SanujaRupasinghe/WaveHarmony/Documentation/Pictures/final design.PNG

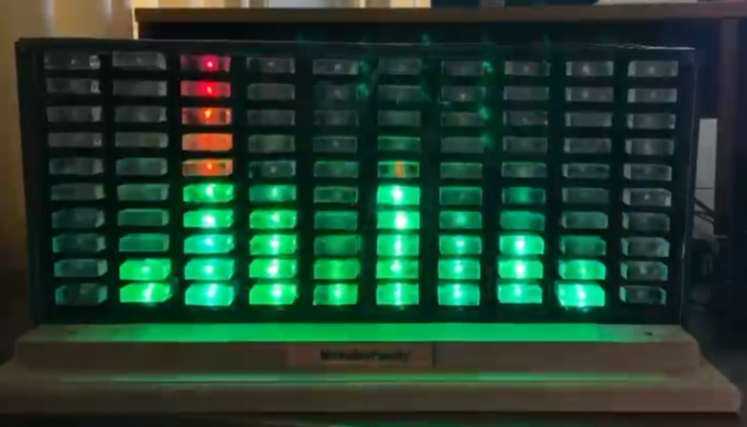
Documentation/Pictures/final design.PNG
