SanujaRupasinghe/WaveHarmony/Documentation/Pictures/PCB.jpg

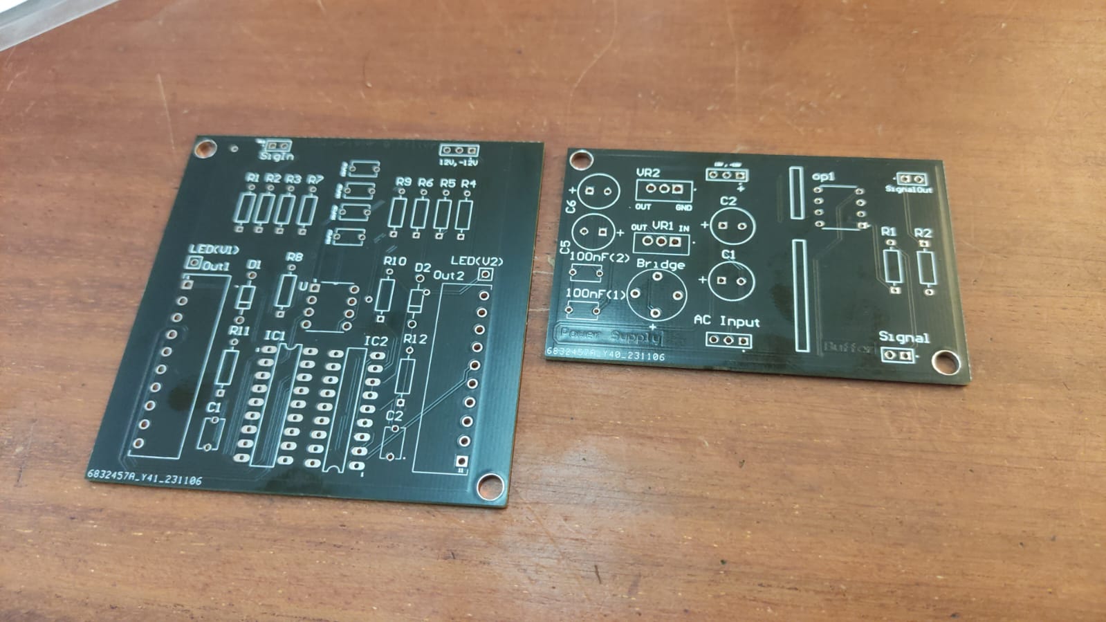
Documentation/Pictures/PCB.jpg
