SanujaRupasinghe/WaveHarmony/Documentation/Pictures/acrylic .jpg

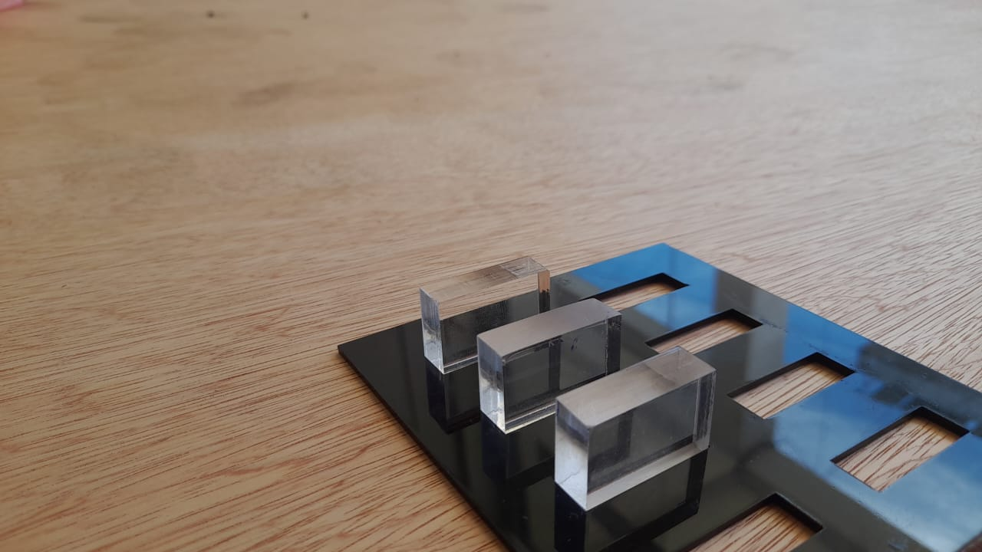
Documentation/Pictures/acrylic .jpg
