SanujaRupasinghe/WaveHarmony/Documentation/Pictures/working power supply.jpg

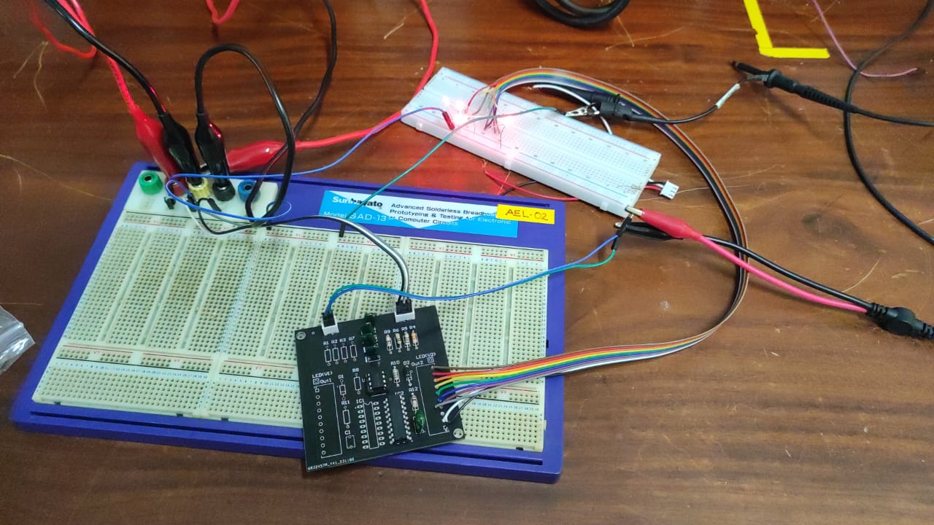
Documentation/Pictures/working power supply.jpg
