SanujaRupasinghe/WaveHarmony/Enclosure/Assembly.SLDASM

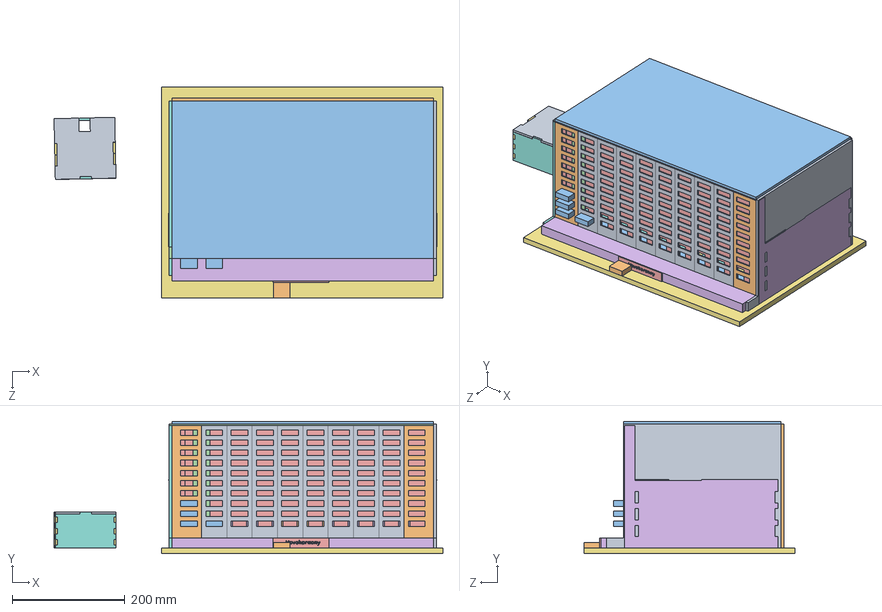
[picture p34: CAD file, 2024-08-10]
Enclosure/Assembly.SLDASM
691.3 x 235.0 x 375.0 mm
BlockHolderMid x 8
BlockHolderSide x 2
Blocks x 4
BlockHolderMidSupport
BlockHolderSideSupport
FontSupport
Base
FilterLEDDrivePCB x 5
PowerSupply x 2
Transformer
BackSupport x 2
Transformer Front x 2
Transormer Side x 2
Transormer Top
Name
N - LR
N - LR 2
N - Back
N - Top
