SanujaRupasinghe/WaveHarmony/Enclosure/Transformer/TransformerAssembly.SLDASM

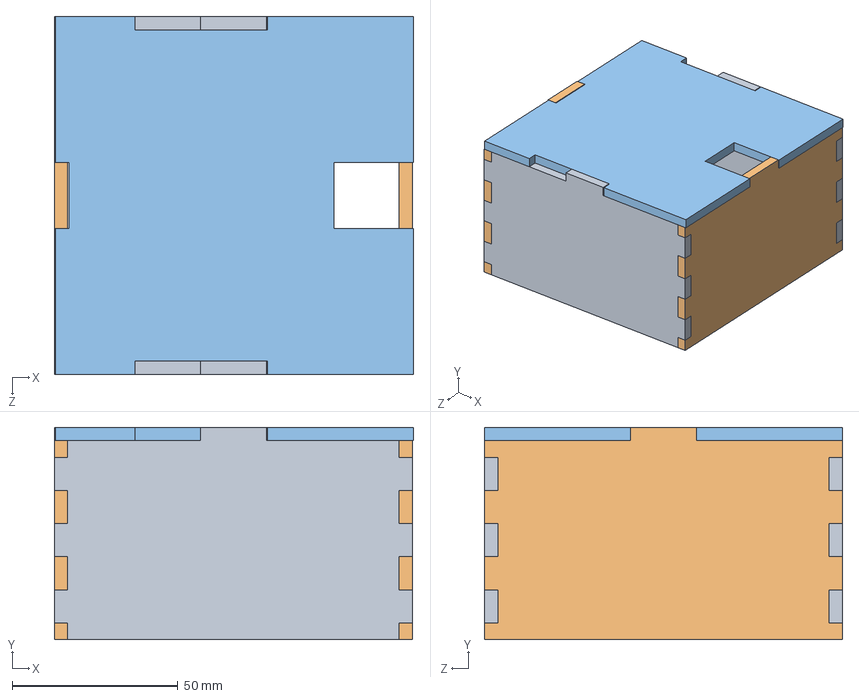
[picture p35: CAD file, 2024-08-10]
Enclosure/Transformer/TransformerAssembly.SLDASM
108.3 x 64.0 x 108.0 mm
Transformer Front x 2
Transormer Side x 2
Transormer Top
