SanujaRupasinghe/WaveHarmony/Enclosure/Support/Sup.SLDPRT

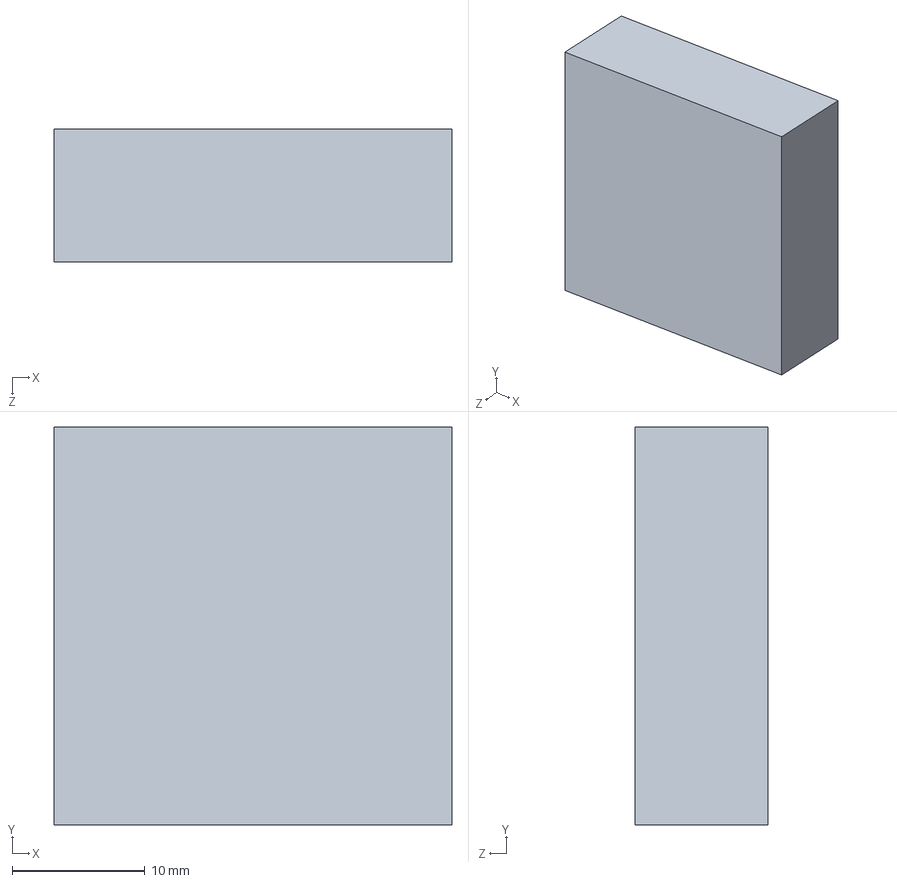
[picture p36: CAD file, 2024-08-10]
Enclosure/Support/Sup.SLDPRT
30.0 x 30.0 x 10.0 mm
