SanujaRupasinghe/WaveHarmony/Enclosure/Transformer/Transformer Front.SLDPRT

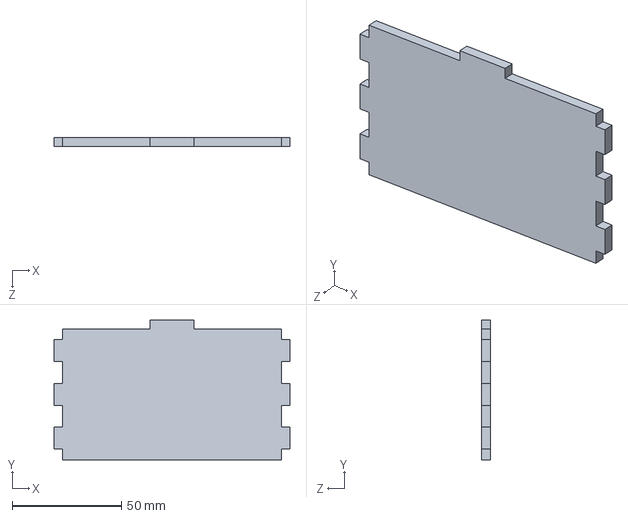
[picture p37: CAD file, 2024-08-10]
Enclosure/Transformer/Transformer Front.SLDPRT
108.0 x 64.0 x 4.00 mm
