SanujaRupasinghe/WaveHarmony/Enclosure/FilterLEDDrivePCB.SLDPRT

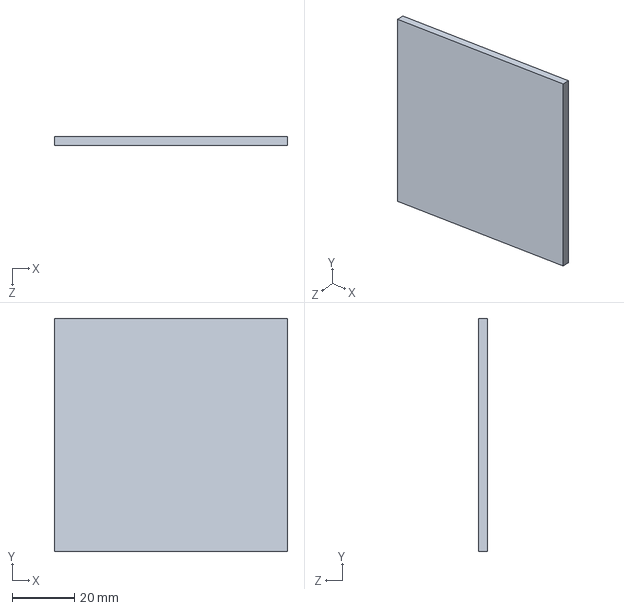
[picture p38: CAD file, 2024-08-10]
Enclosure/FilterLEDDrivePCB.SLDPRT
75.0 x 75.0 x 3.00 mm
