SanujaRupasinghe/WaveHarmony/Enclosure/HideBulbsHighTop.SLDPRT

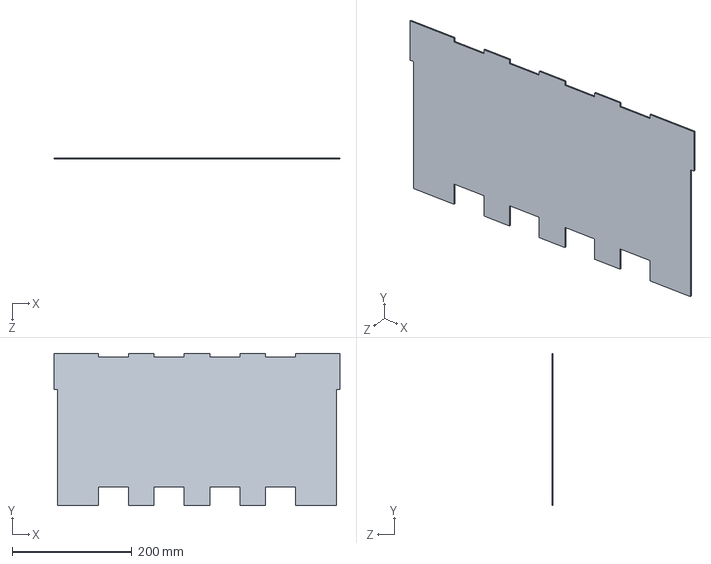
[picture p39: CAD file, 2024-08-10]
Enclosure/HideBulbsHighTop.SLDPRT
477.0 x 254.0 x 2.00 mm
