SanujaRupasinghe/WaveHarmony/Enclosure/BackSupport.SLDPRT

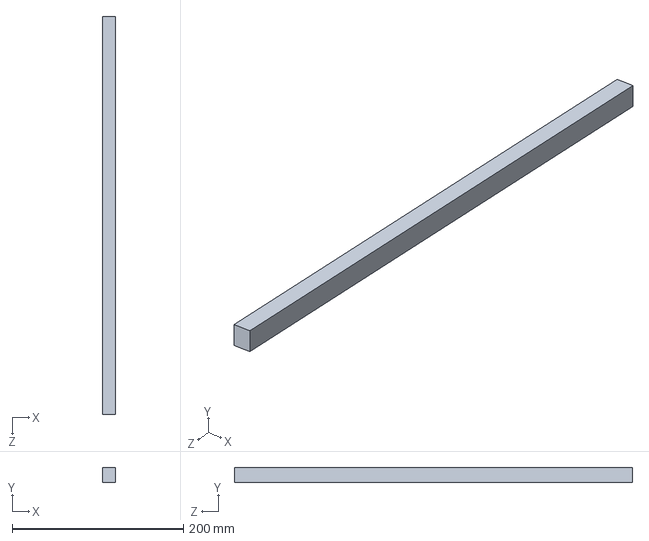
[picture p40: CAD file, 2024-08-10]
Enclosure/BackSupport.SLDPRT
15.0 x 18.0 x 465.0 mm
