SanujaRupasinghe/WaveHarmony/Enclosure/Transformer/Transormer Top.SLDPRT

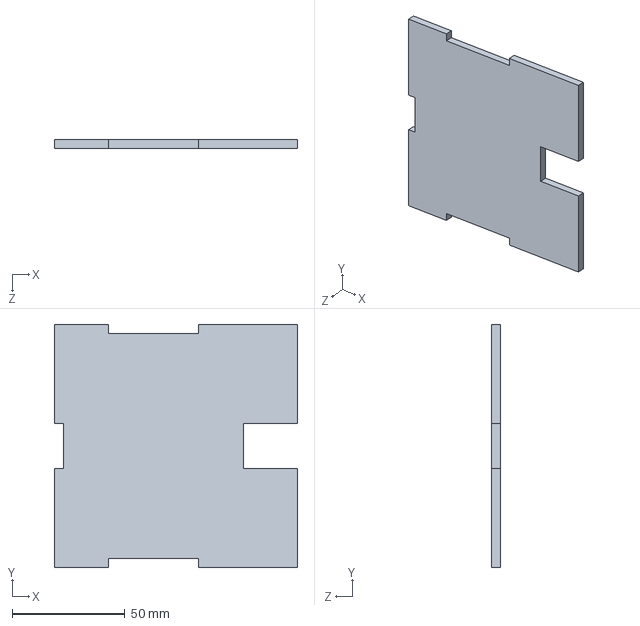
[picture p41: CAD file, 2024-08-10]
Enclosure/Transformer/Transormer Top.SLDPRT
108.0 x 108.0 x 4.00 mm
