SanujaRupasinghe/WaveHarmony/Enclosure/Transformer Front.SLDPRT

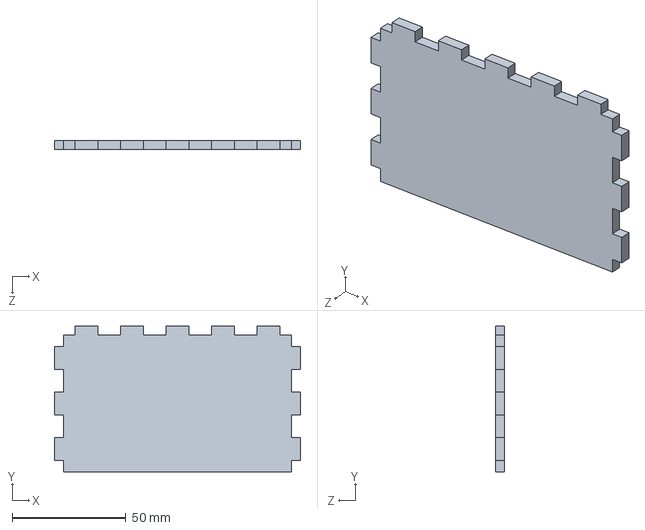
[picture p42: CAD file, 2024-08-10]
Enclosure/Transformer Front.SLDPRT
108.0 x 64.0 x 4.00 mm
