SanujaRupasinghe/WaveHarmony/Enclosure/N - Top.SLDPRT

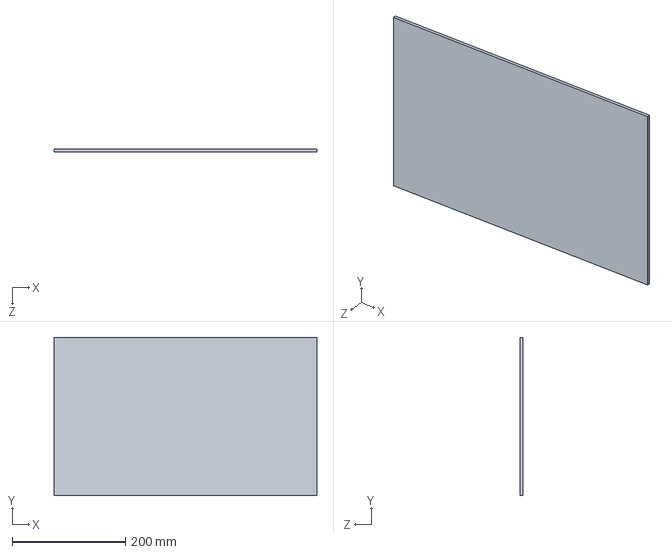
[picture p43: CAD file, 2024-08-10]
Enclosure/N - Top.SLDPRT
465.0 x 280.0 x 5.00 mm
