SanujaRupasinghe/WaveHarmony/Enclosure/BlockHolderSideSupport.SLDPRT

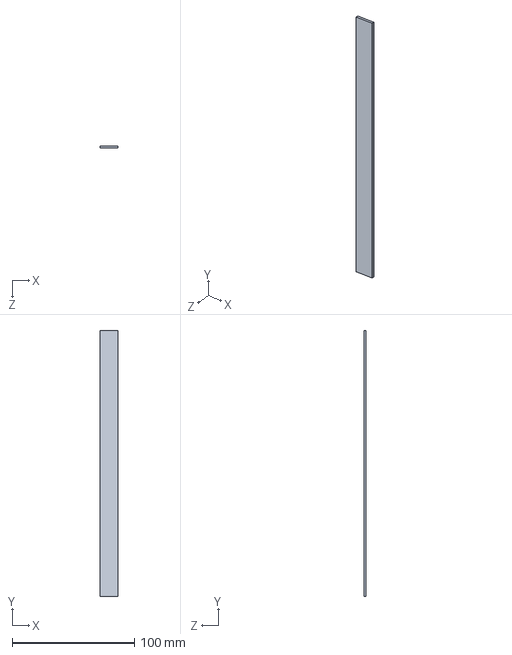
[picture p44: CAD file, 2024-08-10]
Enclosure/BlockHolderSideSupport.SLDPRT
15.0 x 218.0 x 2.00 mm
