SanujaRupasinghe/WaveHarmony/Enclosure/Transformer Top Good.SLDPRT

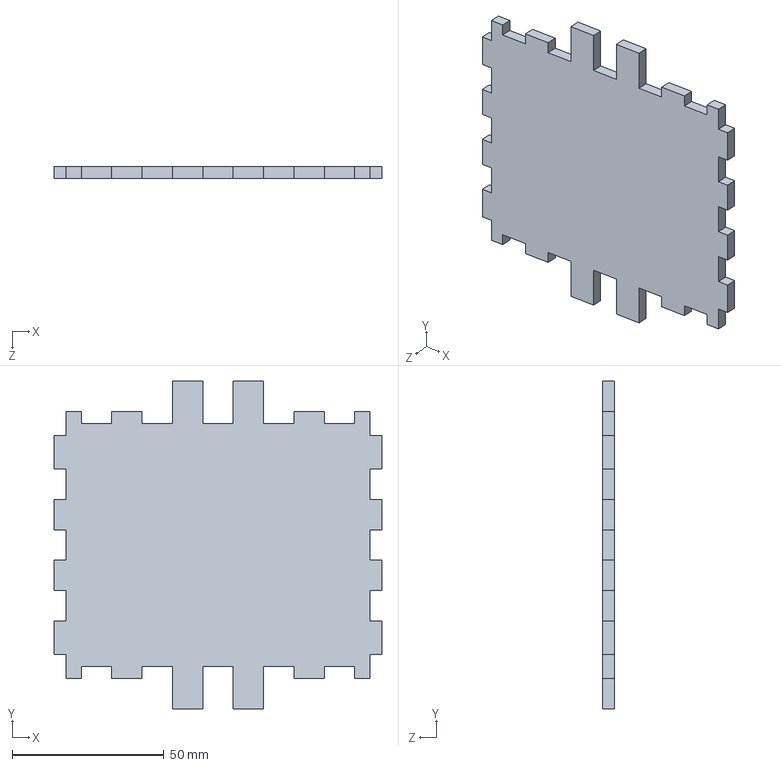
[picture p45: CAD file, 2024-08-10]
Enclosure/Transformer Top Good.SLDPRT
108.0 x 108.0 x 4.00 mm
