SanujaRupasinghe/WaveHarmony/Enclosure/Transformer Side V2.SLDPRT

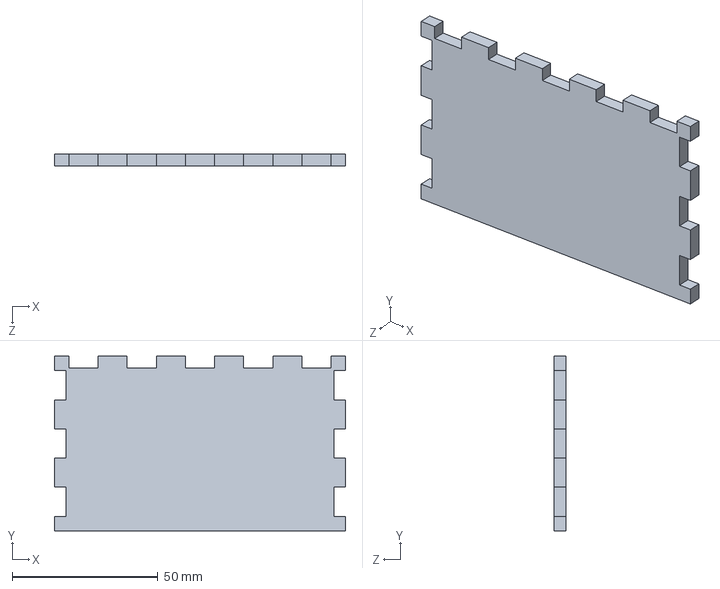
[picture p46: CAD file, 2024-08-10]
Enclosure/Transformer Side V2.SLDPRT
100.0 x 60.0 x 4.00 mm
