SanujaRupasinghe/WaveHarmony/Enclosure/HideWires.SLDPRT

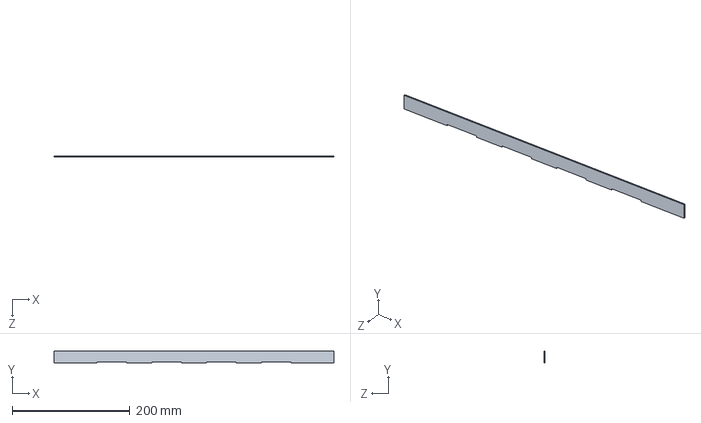
[picture p47: CAD file, 2024-08-10]
Enclosure/HideWires.SLDPRT
475.0 x 21.0 x 2.00 mm
