SanujaRupasinghe/WaveHarmony/Enclosure/Transformer.SLDPRT

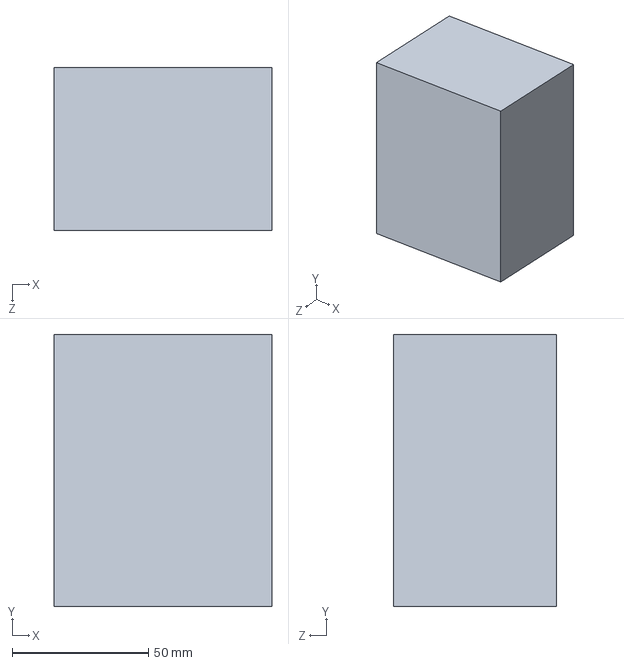
[picture p48: CAD file, 2024-08-10]
Enclosure/Transformer.SLDPRT
80.0 x 100.0 x 60.0 mm
