SanujaRupasinghe/WaveHarmony/Enclosure/Blocks.SLDPRT

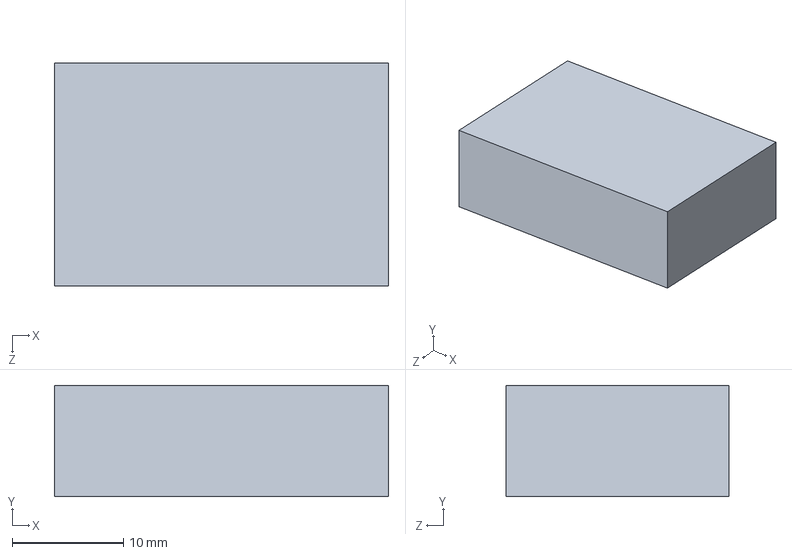
[picture p49: CAD file, 2024-08-10]
Enclosure/Blocks.SLDPRT
30.0 x 10.0 x 20.0 mm
