SanujaRupasinghe/WaveHarmony/Enclosure/N - LR 2.SLDPRT

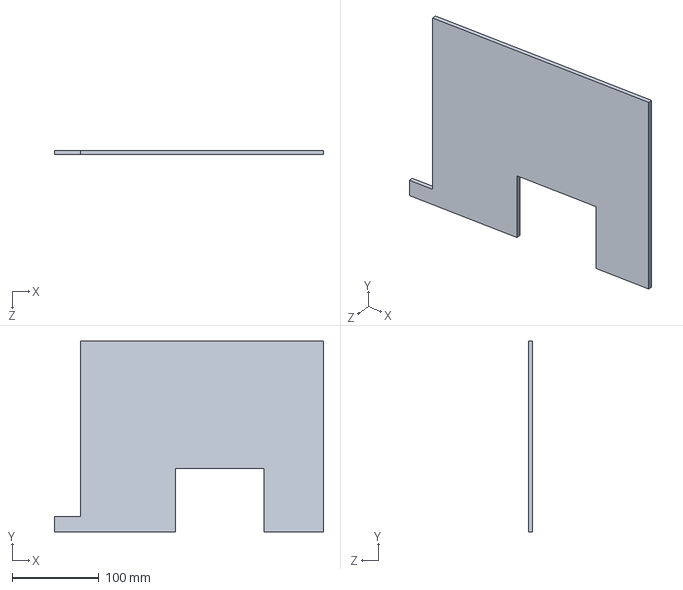
[picture p50: CAD file, 2024-08-10]
Enclosure/N - LR 2.SLDPRT
310.0 x 220.0 x 5.00 mm
