SanujaRupasinghe/WaveHarmony/Enclosure/HideBulbs.SLDPRT

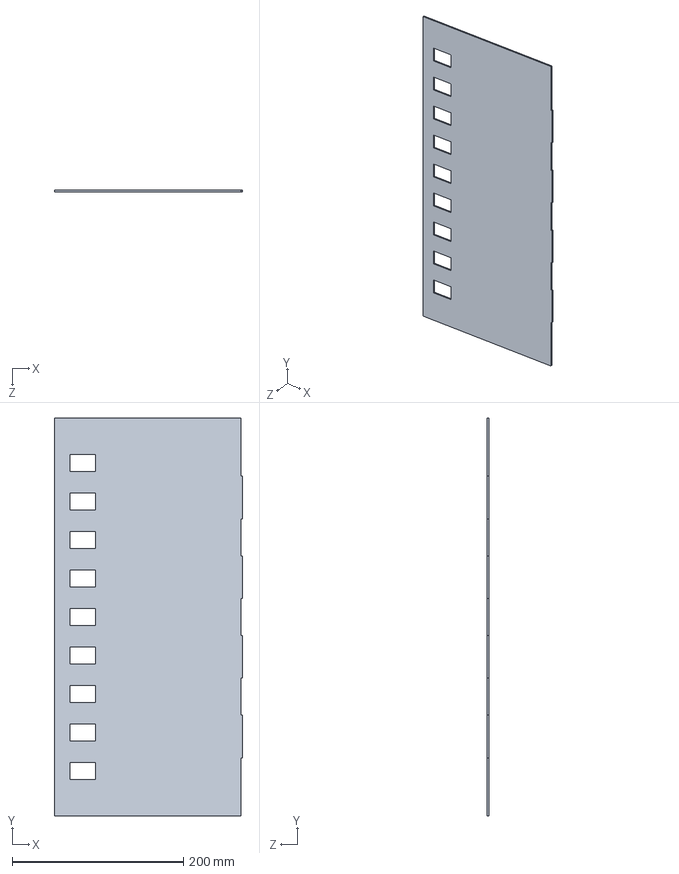
[picture p51: CAD file, 2024-08-10]
Enclosure/HideBulbs.SLDPRT
220.0 x 465.0 x 2.00 mm
