SanujaRupasinghe/WaveHarmony/Enclosure/Base.SLDPRT

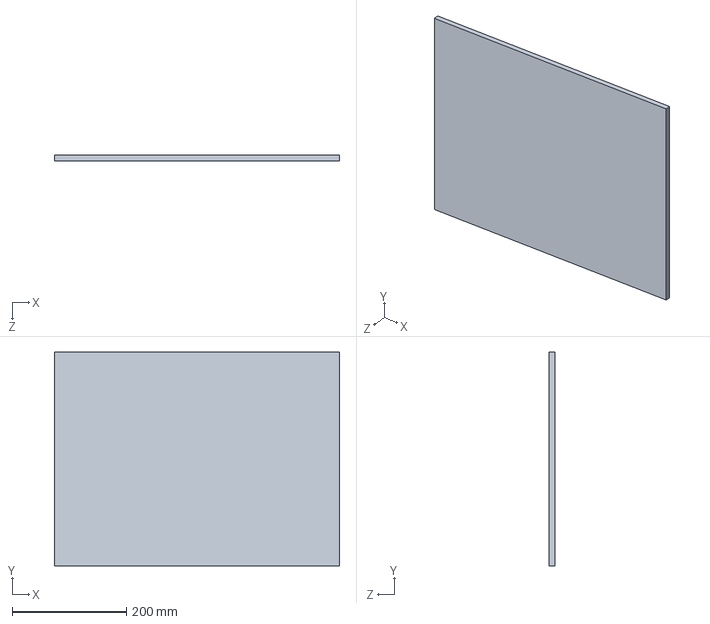
[picture p52: CAD file, 2024-08-10]
Enclosure/Base.SLDPRT
500.0 x 375.0 x 10.0 mm
