SanujaRupasinghe/WaveHarmony/Enclosure/BlockHolderMid.SLDPRT

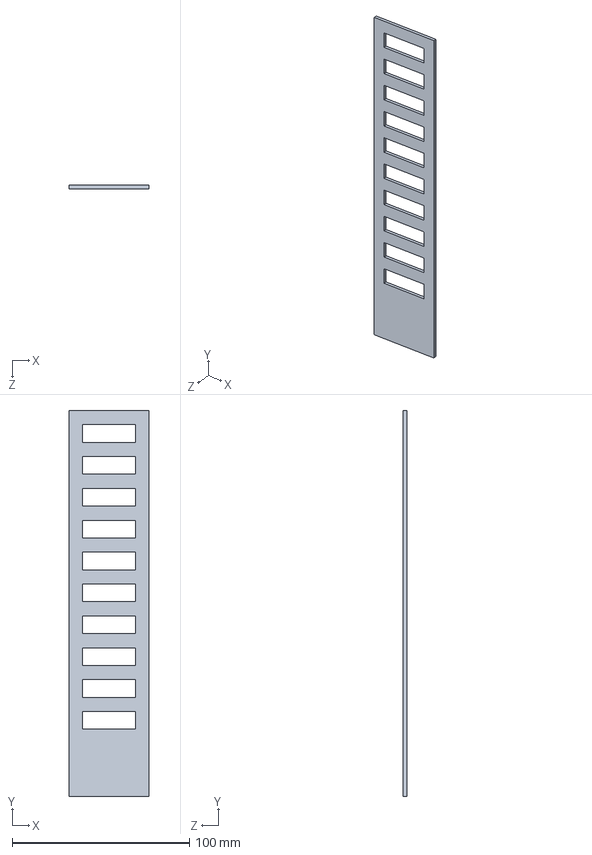
[picture p53: CAD file, 2024-08-10]
Enclosure/BlockHolderMid.SLDPRT
45.0 x 218.0 x 2.00 mm
