SanujaRupasinghe/WaveHarmony/Enclosure/PowerSupply.SLDPRT

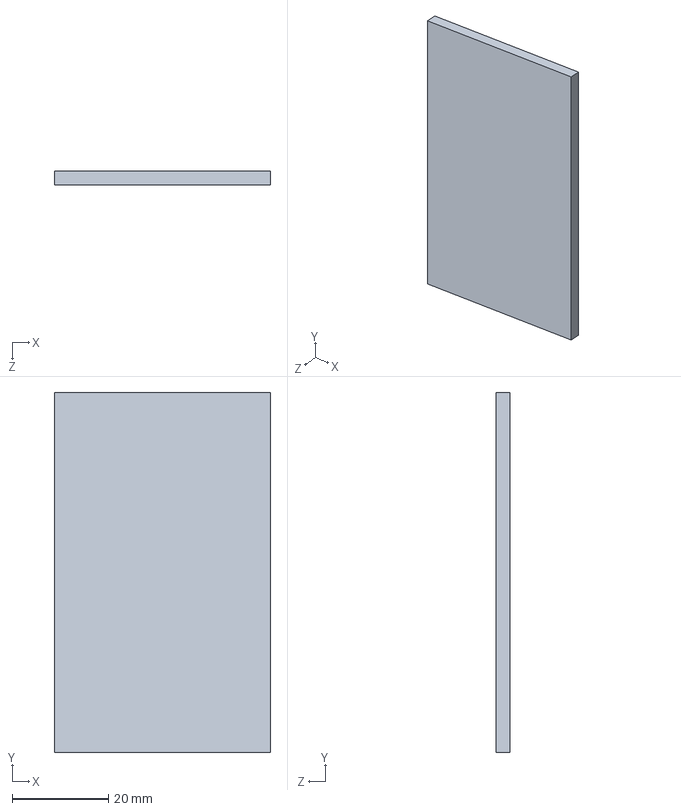
[picture p54: CAD file, 2024-08-10]
Enclosure/PowerSupply.SLDPRT
45.0 x 75.0 x 3.00 mm
