SanujaRupasinghe/WaveHarmony/Enclosure/HideBulbsHighSide.SLDPRT

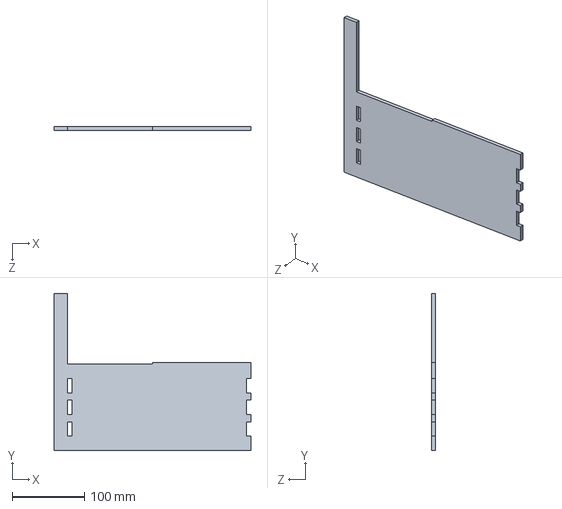
[picture p55: CAD file, 2024-08-10]
Enclosure/HideBulbsHighSide.SLDPRT
273.0 x 218.0 x 5.00 mm
