SanujaRupasinghe/WaveHarmony/Enclosure/N - Back.SLDPRT

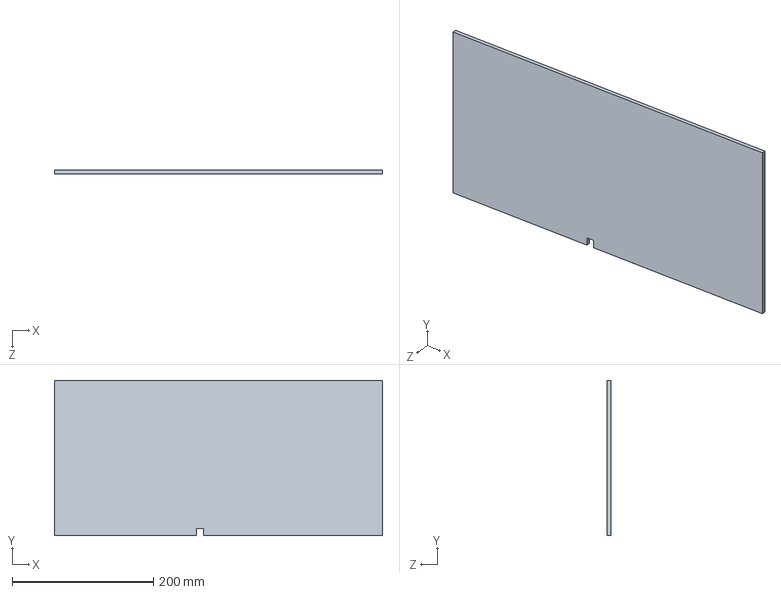
[picture p56: CAD file, 2024-08-10]
Enclosure/N - Back.SLDPRT
465.0 x 220.0 x 5.00 mm
