SanujaRupasinghe/WaveHarmony/Enclosure/HideBulbsHighBack.SLDPRT

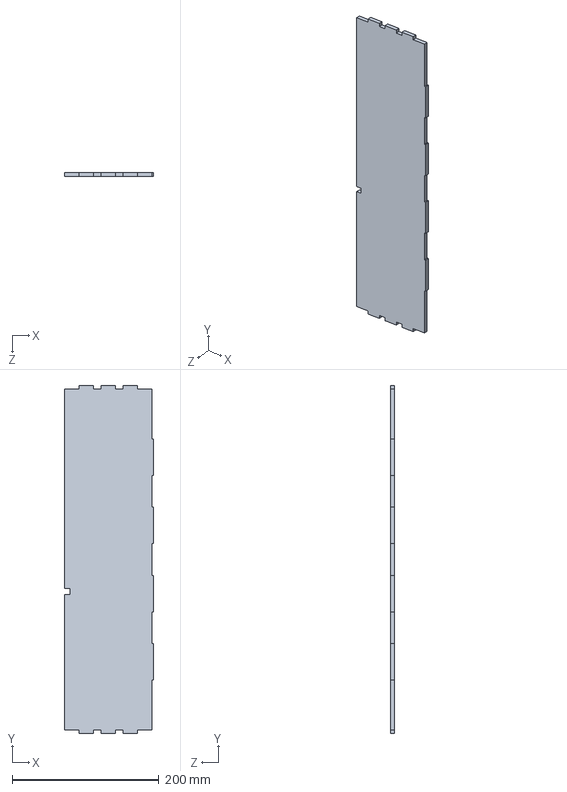
[picture p57: CAD file, 2024-08-10]
Enclosure/HideBulbsHighBack.SLDPRT
122.0 x 475.0 x 6.00 mm
