SanujaRupasinghe/WaveHarmony/Enclosure/Name.SLDPRT

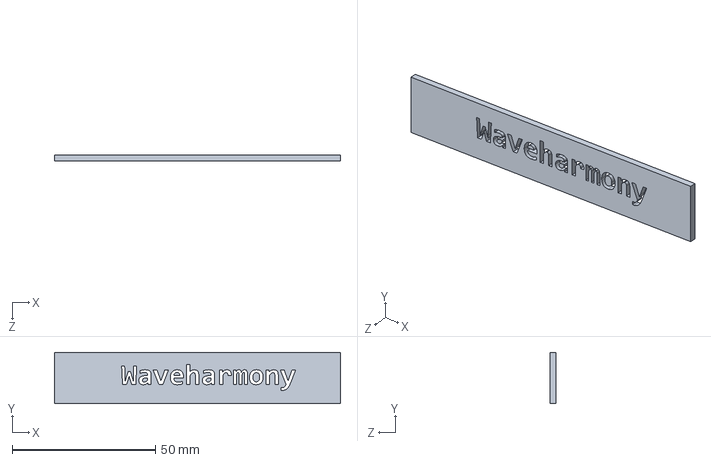
[picture p58: CAD file, 2024-08-10]
Enclosure/Name.SLDPRT
100.0 x 18.0 x 2.00 mm
