SanujaRupasinghe/WaveHarmony/Enclosure/BlockHolderMidSupport.SLDPRT

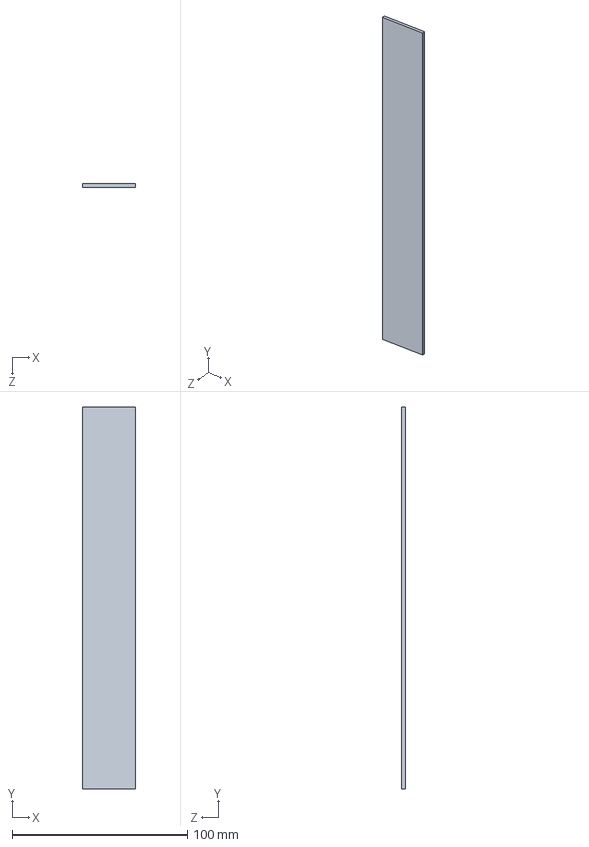
[picture p59: CAD file, 2024-08-10]
Enclosure/BlockHolderMidSupport.SLDPRT
30.0 x 218.0 x 2.00 mm
