SanujaRupasinghe/WaveHarmony/Enclosure/N - LR.SLDPRT

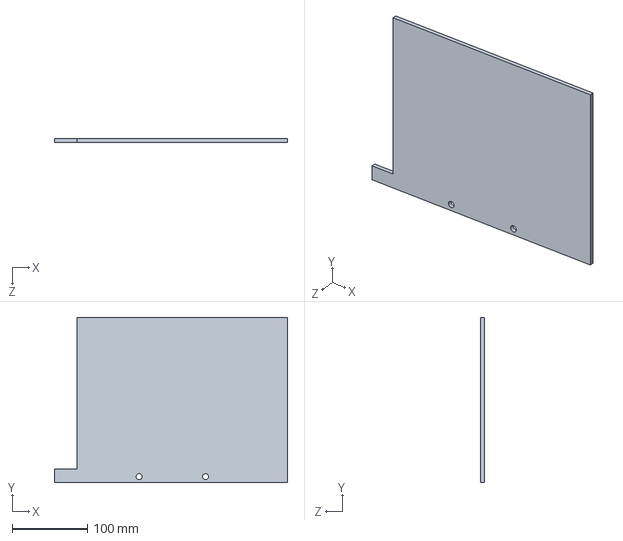
[picture p60: CAD file, 2024-08-10]
Enclosure/N - LR.SLDPRT
310.0 x 220.0 x 5.00 mm
