SanujaRupasinghe/WaveHarmony/Enclosure/HideBulbsHigh.SLDPRT

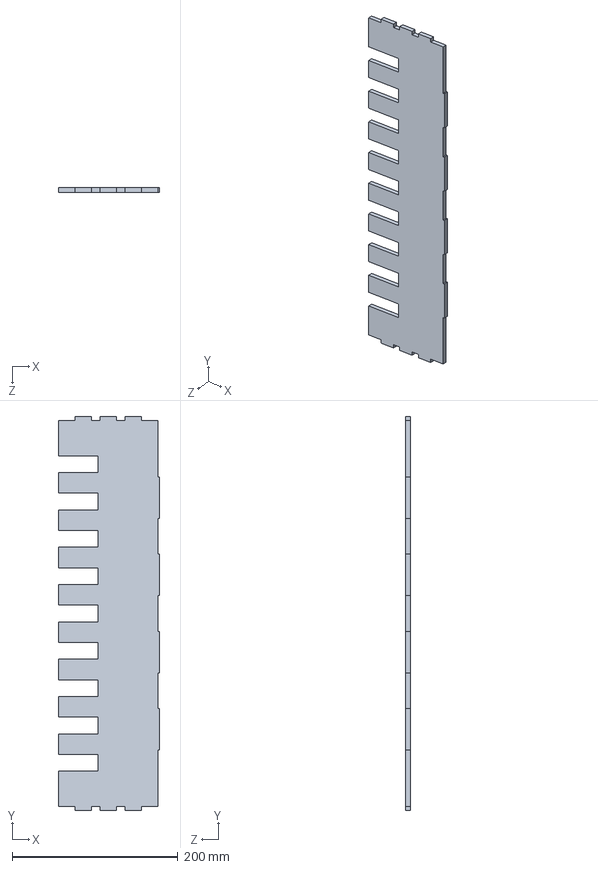
[picture p61: CAD file, 2024-08-10]
Enclosure/HideBulbsHigh.SLDPRT
122.0 x 475.0 x 6.00 mm
