SanujaRupasinghe/WaveHarmony/Enclosure/BlockHolderSide.SLDPRT

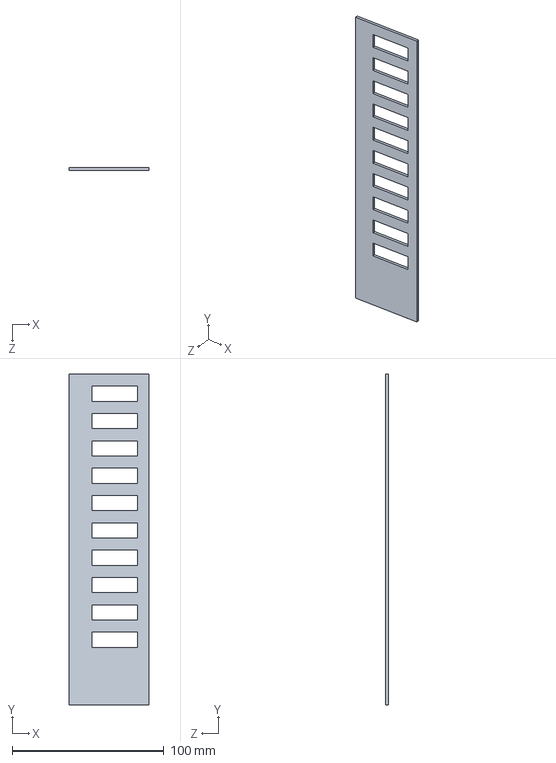
[picture p62: CAD file, 2024-08-10]
Enclosure/BlockHolderSide.SLDPRT
52.5 x 218.0 x 2.00 mm
