SanujaRupasinghe/WaveHarmony/Enclosure/Transformer Side.SLDPRT

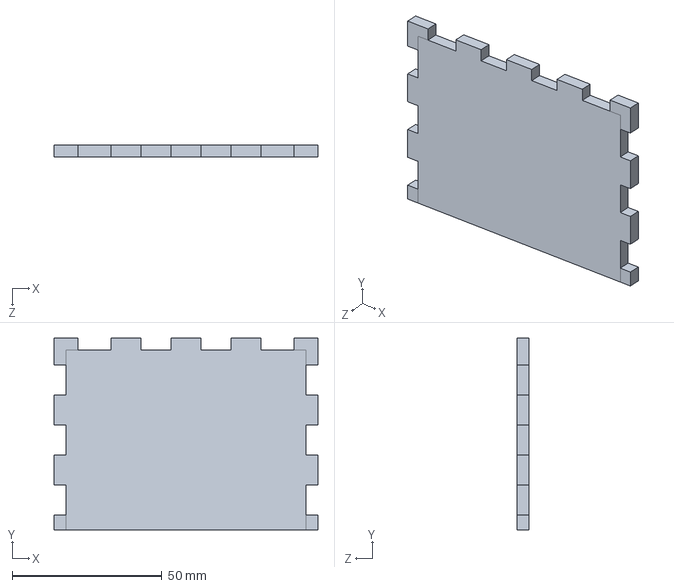
[picture p63: CAD file, 2024-08-10]
Enclosure/Transformer Side.SLDPRT
88.0 x 64.0 x 4.00 mm
