SanujaRupasinghe/WaveHarmony/(list of files, cad)

Other CAD files:
Enclosure/Transformer/Transormer Side.SLDPRT
Enclosure/FontSupport.SLDPRT
Enclosure/HideBulbsHighSide2.SLDPRT
