SanujaRupasinghe/WaveHarmony/Circuit_And_Simulation/Simulations/Filters.asc

C1: cap; 10n
C2: cap; 10n
C3: cap; 10n
C4: cap; 10n
C5: cap; 10µ
C6: cap; 10n
C7: cap; 10n
C8: cap; 10n
C9: cap; 10n
C10: cap; 10n
C11: cap; 10n
C12: cap; 10n
C13: cap; 10n
C14: cap; 10n
C15: cap; 10n
C16: cap; 10n
C17: cap; 10n
C18: cap; 10n
C19: cap; 10n
C20: cap; 10n
C21: cap; 10n
C22: cap; 10µ
C23: cap; 10µ
C24: cap; 10µ
C25: cap; 10µ
C26: cap; 10µ
C27: cap; 10µ
C28: cap; 10µ
C29: cap; 10µ
C30: cap; 10µ
D1: diode
D2: diode
D3: diode
D4: diode
D5: diode
D6: diode
D7: diode
D8: diode
D9: diode
D10: diode
R1: res; 1000k
R2: res; 68k
R3: res; 4000k
R4: res; 35k
R5: res; 500k
R6: res; 2000k
R7: res; 100k
R8: res; 16k
R9: res; 1000k
R10: res; 2k
R11: res; 128k
R12: res; 1k
R13: res; 64k
R14: res; 0.5k
R15: res; 32k
R16: res; 9k
R17: res; 500k
R18: res; 4k
R19: res; 250k
R20: res; 0.25k
R21: res; 16k
R22: res; 0.13k
R23: res; 8k
R24: res; 250k
R25: res; 128k
R26: res; 65k
R27: res; 32k
R28: res; 16k
R29: res; 8k
R30: res; 4k
R31: res; 2k
R32: res; 100k
R33: res; 100k
R34: res; 100k
R35: res; 100k
R36: res; 100k
R37: res; 100k
R38: res; 100k
R39: res; 100k
R40: res; 100k
U1: TL072
U2: TL072
U3: TL072
U4: TL072
U5: TL072
U6: TL072
U7: TL072
U8: TL072
U9: TL072
U10: TL072
V1: voltage; 15
V2: voltage; 15
V3: voltage; SINE(0 5 500); AC -1
Named nets: 0, sig
.ac dec 1000 10 5000
