SanujaRupasinghe/WaveHarmony/Circuit_And_Simulation/Simulations/Led Driver/LM3915_Test.asc

D1a: LED
D1b: LED
D2a: LED
D2b: LED
D9a: LED
D9b: LED
D10a: LED
D10b: LED
R1a: res; 1k2
R1b: res; 1k8
R2a: res; 200
R2b: res; 10k
R3a: res; 22k
U1: LM3915
U2: LM3915
V1: voltage; 2
V2: voltage; 12
V3: voltage; PULSE(1 8 0 1)
Vled: voltage; 5
Named nets: 0, In, hi1, lo1, V+, hi2, V-, lo2
.tran 0 1 1m uic
LM3915 Test Jig
Sw1
Sw2
Sw3
