SanujaRupasinghe/WaveHarmony/Circuit_And_Simulation/Simulations/Led Driver/LM3914 andLM3915/LM3914_Test.asc

D1: LED
D2: LED
D3: LED
D4: LED
D5: LED
D6: LED
D7: LED
D8: LED
R1a: res; 1k2
R1b: res; 1k8
R2a: res; 1k2
R2b: res; 8k2
R3a: res; 22k
U1: LM3914
U2: LM3914
V1: voltage; 2
V2: voltage; 12
V3: voltage; PULSE(0 10 0 1)
Vled: voltage; 5
Named nets: 0, In, hi1, lo1, V+, hi2, V-, lo2
LM3914 Test Jig
Sw1
Sw2
Sw3
Select LED type before running sim!
.dc v3 0 10 .001
