SanujaRupasinghe/WaveHarmony/Circuit_And_Simulation/Simulations/Draft1.asc

C1: cap; 1n
C2: cap; 1n
R1: res; 160k
R2: res; 636k
R3: res; 53k
U1: OP27
V1: voltage; 15
V2: voltage; 15
V3: voltage; ""; AC 1
Named nets: 0, Vout, Vin
.ac dec 100 10 2.2k
