SanujaRupasinghe/WaveHarmony/Circuit_And_Simulation/Simulations/Filter Simulations/ActiveBandpassFilter.asc

C1: cap; 0.01µ
C2: cap; 4.7n
R1: res; 470
R2: res; 1000000
R3: res; 22k
U1: opamp2; LM741
V1: voltage; ""; AC AC1 0
V2: voltage; 15
V3: voltage; 15
Named nets: 0
.include lm741.lib
.ac dec 20 1 1000k
