SanujaRupasinghe/WaveHarmony/Circuit_And_Simulation/Simulations/Filter Simulations/PassiveBandpassFilter.asc

C1: cap; 35n
C2: cap; 29n
R1: res; 10k
R2: res; 10k
V1: voltage; SINE(0 1 500); AC 1 0
Named nets: 0, out, in
HPF 450hz
LPF 550hz
.ac dec 100 1 200000000
