SanujaRupasinghe/WaveHarmony/Circuit_And_Simulation/Simulations/LM741/lm741.asc

U1: opamp2; LM741
V+: voltage; 15
v-: voltage; 15
Named nets: 0
.include lm741.lib
