SanujaRupasinghe/WaveHarmony/Circuit_And_Simulation/Simulations/TL072/Filters.asc

C1: cap; 10n
C2: cap; 10n
C3: cap; 10n
C4: cap; 10n
R1: res; 63.66k
R2: res; 4k
R3: res; 254k
R4: res; 2.12k
R5: res; 31.83k
R6: res; 127.32k
U1: TL072
U2: TL072
V1: voltage; 15
V2: voltage; 15
V3: voltage; ""; AC -1
Named nets: 0
.ac lin 100 10 2k
