SanujaRupasinghe/WaveHarmony/Circuit_And_Simulation/Simulations/Led Driver/LM3915asc/LM3915asc.asc

B1: bi; I=1u-10*i(rs)*(v(sig)>v(rlo))*((v(sig)<(v(d1)+1m))|(v(m)+0.1>=v(v+)))
B1a: bi; I=150u*(v(m)<(v(v+)-0.1))*(v(sig)>v(rlo))
B2: bi; I=1u-10*i(rs)*(v(sig)>v(d1))*((v(sig)<v(d2)+1m)|(v(m)+0.1>=v(v+)))
B3: bi; I=1u-10*i(rs)*(v(sig)>v(d2))*((v(sig)<v(d3)+1m)|(v(m)+0.1>=v(v+)))
B4: bi; I=1u-10*i(rs)*(v(sig)>v(d3))*((v(sig)<v(d4)+1m)|(v(m)+0.1>=v(v+)))
B5: bi; I=1u-10*i(rs)*(v(sig)>v(d4))*((v(sig)<v(d5)+1m)|(v(m)+0.1>=v(v+)))
B6: bi; I=1u-10*i(rs)*(v(sig)>v(d5))*((v(sig)<v(d6)+1m)|(v(m)+0.1>=v(v+)))
B7: bi; I=1u-10*i(rs)*(v(sig)>v(d6))*((v(sig)<v(d7)+1m)|(v(m)+0.1>=v(v+)))
B8: bi; I=1u-10*i(rs)*(v(sig)>v(d7))*((v(sig)<v(d8)+1m)|(v(m)+0.1>=v(v+)))
B9: bi; I=1u-10*i(rs)*(v(sig)>v(d8))*((v(sig)<v(d9)+1m)|(v(m)+0.1>=v(v+)))
B10: bi; I=1u-10*i(rs)*(v(sig)>v(d9))*((v(m)+0.1>=v(v+))|(v(m)>=v(L9)-0.9))
B11: bv; V=min(v(v+)-v(v-)-.3,1.25+v(adj)-v(v-))
B15: bi; I=1m1-4*i(B11)
D1: diode
D2: diode
D3: diode
D4: diode
D5: diode
D6: diode
D7: diode
D8: diode
D9: diode
D10: diode
I1: current; 75µ
R1: res; 0.39k
R2: res; 0.53k
R3: res; 0.76k
R4: res; 1.07k
R5: res; 1.51k
R6: res; 2.14k
R7: res; 3.03k
R8: res; 4.28k
R9: res; 6.06k
R10: res; 8.57k
Ric: res; 4k
Rm1: res; 350k
Rm2: res; 10meg
Rs: res; 50
X1: jumper
Named nets: Sig, Rlo, L1, V-, L2, L3, L4, L5, L6, L7, L8, L9, L10, Ref, Rhi, Bar/_dot, V+, Adj, m, d1, d2, d3, d4, d5, d6, d7, d8, d9
3
9
5
7
6
8
4
LM3915
1
18
17
16
15
14
13
12
11
10
Supply current
2
Limitations / assumptions / approximations :-
2
Pin 9 bias arrangement, Ref source resistance Rs, and Ref plateau at V+ -0.3 are speculative. Clamp diodes D1-D10 are a kludge to prevent B1-B10 producing
fatal run-time errors in the sim for unconnected pins, so introduce slight inaccuracy. Temperature dependence and comparator offsets are not modelled.
[ Model by Geoff Western, aka alec_t ]
Ref source
Mode
Divider ladder
Display current sources x 10
2
3
(Rtotal ~28k)
v1.0
