SanujaRupasinghe/WaveHarmony/(list of files, drawings)

Other design files:
PCB/Filter/Filter.PrjPcb
PCB/Filter/Filter.SchDoc
PCB/Filter/LED drivers.SchDoc
PCB/Filter/main.SchDoc
PCB/Filter/PCB_Filter.PcbDoc
PCB/Filter/Sheet1(Filter).SchDoc
PCB/Power Supply/Power Supply.PcbDoc
PCB/Power Supply/Power Supply.PrjPcb
PCB/Power Supply/powerSupply.SchDoc
PCB/Power Supply/Sheet1(Power supply).SchDoc
