SanujaRupasinghe/WaveHarmony/(commit log)

2024-08-10 data from PCB repo is added to Main Repo
    [Filter.GBL, Filter.GBO, Filter.GBP, Filter.GBS, Filter.GM1, Filter.GTL, Filter.GTO, Filter.GTP]
2024-08-10 data form Circuit_And_Simulation repo are added to Main repo
    [Filter Resistors.xlsx]
2024-08-10 data from Enclosure repo are added to Main Repo
    [Assembly.SLDASM, BackSupport.SLDPRT, Base.SLDPRT, BlockHolderMid.SLDPRT, BlockHolderMidSupport.SLDPRT, BlockHolderSide.SLDPRT, BlockHolderSideSupport.SLDPRT, Blocks.SLDPRT]
